PuscasuDorin/VGA_on_Xilinx_FPGA/src/VGA/vga_controller.sv

module vga_controller#(
    // VGA timing parameters for 640x480 @ 60Hz
    parameter H_ACTIVE_VIDEO = 640,
    parameter H_SYNC_PULSE   = 96 ,
    parameter H_FRONT_PORCH  = 16 ,
    parameter H_BACK_PORCH   = 48 ,

    parameter V_ACTIVE_VIDEO = 480,
    parameter V_SYNC_PULSE   = 2  ,
    parameter V_FRONT_PORCH  = 10 ,
    parameter V_BACK_PORCH   = 33
)(
    input  logic       clk    ,
    input  logic       rst_n  ,

    output logic       hsync  ,
    output logic       vsync  ,

    output logic [9:0] h_count, // Horizontal pixel counter
    output logic [9:0] v_count, // Vertical line counter

    output logic       video_on
);
  
    localparam H_TOTAL = H_SYNC_PULSE + H_BACK_PORCH + H_ACTIVE_VIDEO + H_FRONT_PORCH;
    localparam V_TOTAL = V_SYNC_PULSE + V_BACK_PORCH + V_ACTIVE_VIDEO + V_FRONT_PORCH;

    logic h_count_rst;
    logic v_count_rst;

    // Horizontal and vertical sync signals
    assign hsync = ~((h_count >= (H_ACTIVE_VIDEO + H_FRONT_PORCH)) & (h_count < (H_ACTIVE_VIDEO + H_FRONT_PORCH + H_SYNC_PULSE))); // Active low
    assign vsync = ~((v_count >= (V_ACTIVE_VIDEO + V_FRONT_PORCH)) & (v_count < (V_ACTIVE_VIDEO + V_FRONT_PORCH + V_SYNC_PULSE))); // Active low
    
    // Horizontal and vertical counters
    assign h_count_rst = (h_count == H_TOTAL - 1);
    assign v_count_rst = (v_count == V_TOTAL - 1);

    always_ff @(posedge clk or negedge rst_n) begin
        if(~rst_n)      h_count <= 0          ; else
        if(h_count_rst) h_count <= 0          ; else
                        h_count <= h_count + 1;
    end

    always_ff @(posedge clk or negedge rst_n) begin
        if(~rst_n)                      v_count <= 0          ; else
        if(h_count_rst &&  v_count_rst) v_count <= 0          ; else
        if(h_count_rst && !v_count_rst) v_count <= v_count + 1;
    end

    assign video_on = (h_count < H_ACTIVE_VIDEO && v_count < V_ACTIVE_VIDEO);

endmodule
