PuscasuDorin/VGA_on_Xilinx_FPGA/(commit log)

2026-07-08 feat: add vga driver module and vga tb
2026-07-09 feat: add top module with driver and 25.175 PLL
2026-07-10 feat: add speed switch to the square
2026-07-14 feat: create module files for ov7670 camera
2026-07-16 feat: connect and run on basys3 and vga camera module
2026-07-21 feat: add 'intruder' message to the screen when PIR sensor detect presence
2026-07-22 fix: vga image display by convertig from RGB to YUV
    [vga_img_display .sv]
